mokomull/c64-cartridge/edge connector breakout/edge connector breakout.sch

## KiCad design edge connector breakout/edge connector breakout.sch (2020-06-07)

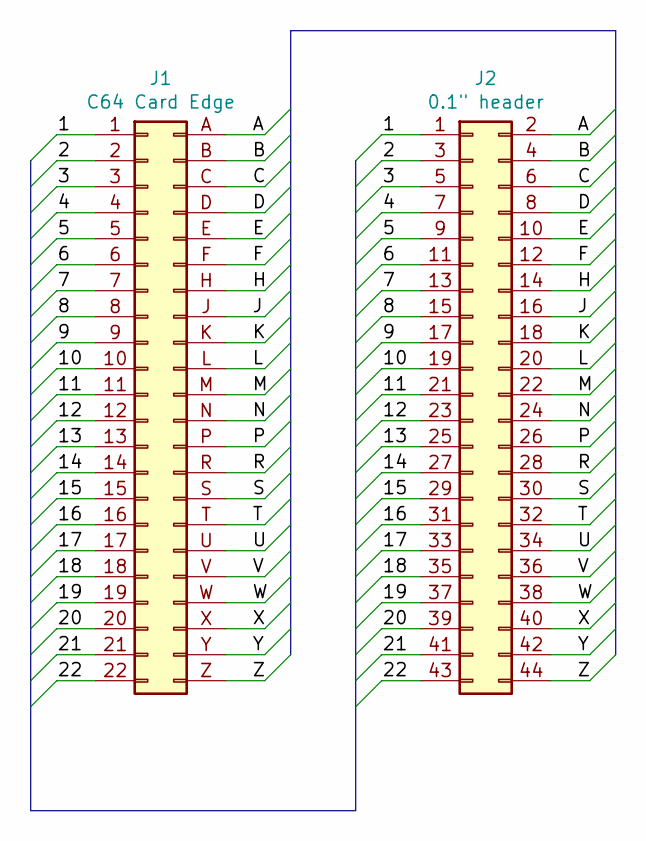
[picture p1: schematic edge connector breakout.sch]

Parts:
J1: C64 Card Edge; Expansion_Cartridge
J2: 0.1\" header; PinHeader_2x22_P2.54mm_Vertical

Connections:
1: J1.1, J2.1
2: J1.2, J2.3
3: J1.3, J2.5
4: J1.4, J2.7
5: J1.5, J2.9
6: J1.6, J2.11
7: J1.7, J2.13
8: J1.8, J2.15
9: J1.9, J2.17
10: J1.10, J2.19
11: J1.11, J2.21
12: J1.12, J2.23
13: J1.13, J2.25
14: J1.14, J2.27
15: J1.15, J2.29
16: J1.16, J2.31
17: J1.17, J2.33
18: J1.18, J2.35
19: J1.19, J2.37
20: J1.20, J2.39
21: J1.21, J2.41
22: J1.22, J2.43
A: J1.A, J2.2
B: J1.B, J2.4
C: J1.C, J2.6
D: J1.D, J2.8
E: J1.E, J2.10
F: J1.F, J2.12
H: J1.H, J2.14
J: J1.J, J2.16
K: J1.K, J2.18
L: J1.L, J2.20
M: J1.M, J2.22
N: J1.N, J2.24
P: J1.P, J2.26
R: J1.R, J2.28
S: J1.S, J2.30
T: J1.T, J2.32
U: J1.U, J2.34
V: J1.V, J2.36
W: J1.W, J2.38
X: J1.X, J2.40
Y: J1.Y, J2.42
Z: J1.Z, J2.44
