mokomull/c64-cartridge/usb/usb.sch

## KiCad design usb/usb.sch (2020-06-08)

Schematic: usb.sch

Parts:
J1: Expansion_Cartridge
U1: STM32F407VGTx; LQFP-100_14x14mm_P0.5mm
U2: 7130LA35PDG; TQFP-64_14x14mm_P0.8mm
U3: S29AL008J
