mokomull/c64-cartridge/(commit log)

2020-06-07 Initial stab at a breakout board
    [C64 Cartridge.kicad_pcb, C64 Cartridge.sch, edge connector breakout.kicad_pcb, edge connector breakout.sch]
2020-06-07 delete footprint cache
    This file seems to get completely replaced every time I load something
    new up in the footprint library.
2020-06-07 breakout pcb: add silkscreen labels for all pins
    [edge connector breakout.kicad_pcb]
2020-06-07 Remove the backup PCB file
    That's what git's for, no?
2020-06-07 Import CBM logo; place logo, serial, copyright
    [edge connector breakout.kicad_pcb]
2020-06-07 Mirror the edge connector in library, reset origin
    Origin of the footprint is now the center of pin 1. I don't know how
    this ever looked right on the PCB layout itself, the footprint hasn't
    been changed since "Initial commit". But somewhere along the line I
    definitely got the board-edge and the circuit side exactly backwards...
    [edge connector breakout.kicad_pcb]
2020-06-08 card edge: move the CrtYd border to 2.3" per spec
    [edge connector breakout.kicad_pcb]
2020-06-08 breakout: add CC0 to the copyright line
    [edge connector breakout.kicad_pcb]
2020-06-08 Move Commodore footprint library to root.
2020-06-08 usb: place some parts on a schematic
    I still need to finish wiring things together, but I'm definitely going
    to need a whole bunch of level shifters, some SRAM, and some flash that
    speaks the Commodore parallel bus. That's the part I'm most worried
    about: the ordering of addresses vs. clock signaling.
    Most of these parts are also not even the right schematic symbol (to be
    fixed later), but I've at least noted down part numbers that I'm going
    to need.
    Also to do later: add the combinatorial logic that's going to drive the
    set of CE# lines.
    [usb.kicad_pcb, usb.sch]
2020-06-14 Try to build a microcontroller-only variant.
    This is dependent on the µC being 5V-tolerant, and the Commodore side
    accepting 3.3V as a "1". I'm probably going to have to upgrade to a
    larger microcontroller package, since
    * a couple pins in port A are not 5V-tolerant, and
    * if the data bus is split into discontiguous portions of a bus, then
    the interrupt is going to need to do some mask+shift+or awfulness,
    which may not be fast enough.
    [usb, microcontroller only.kicad_pcb, usb, microcontroller only.sch]
2020-06-14 µC-only: move D4, D5 to PB0, PB1
    This will take at least a shift and a memory write (and a second memory
    write to the direction register) but this might work.
    Another option might be to shift them up to a high-bit in port A,
    avoiding the second set of direction registers if I can shoot the gap
    just right with alternate-functions
    [usb, microcontroller only.sch]
2020-06-14 µC-only: connect the internal power relugator cap
    [usb, microcontroller only.sch]
2020-07-07 µC-only: wire most of cartridge to µC
    This wires pretty much everything but the DMA lines to the
    microcontroller. That's still a bit too far for me :) Turns out I'm
    not going to need combinatoric logic because the PLA already
    decodes #IOx and #ROMx only when the CPU's AEC line is enable -- i.e.
    when it's the CPU's turn for the bus.
    I mostly grouped the outputs-toward-the-Commodore in the low bits of
    port B, and the inputs-from-the-Commodore in the high bits. Since this
    allows the microcontroller to control #GAME and #EXROM dynamically, as
    well as send interrupts and NMIs, I will hopefully be able to emulate as
    many existing peripherals as possible.
    The resistors on the data bus are cu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
    [usb, microcontroller only.sch]
2020-07-22 firmware: it's a start
    It's just a blinking LED. But it compiles.
2020-08-19 firmware: leave control lines floating for a "1"
    The C64 has built-in pull-ups for the cartridge control lines, so just
    leave them floating at the microcontroller side if we don't want to
    assert them. This prevents the microcontroller trying to output a
    "high" value and end up sinking current because it's being driven by the
    C64 to 5V.
    [main.rs]
2020-08-19 firmware: only output data lines for read requests
    The PLA doesn't decode ROML for writes when #GAME is deasserted anyway,
    but it doesn't hurt to be extra cautious.
    [main.rs]
2021-01-10 firmware: return data from a Frogger cartridge
    I was using the data from `Frogger_(Parker_Brothers).crt`, but that will
    need to be obtained separately.
    It seems that doing memory lookups in the critical section is just a bit
    too slow to reliably get data to the Commodore -- I observe at least one
    bit error about 10% of the time.
    Initially, I was just indexing into the FROGGER object. Thinking that
    the flash wait-states were causing my issues, I added the cache on the
    stack. As far as I can tell, rustc actually optimized that out, which
    is how the read_volatile() came to be.
    Unfortunately, none of those optimizations were enough to reliably read
    the CBM80 header.
    [main.rs]
2021-01-10 firmware: shave off one branch from the inner loop
    This is actually enough to reliably read bytes from the Frogger image!
    It takes long enough at boot that it doesn't immediately trip the
    Commodore's cartridge boot mechanism, but this is enough to launch into
    a green screen upon a SYS64738 command. It still does not seem to
    actually launch the game, though.
    [main.rs]
2021-01-11 firmware: run the 6502 assembler from build.rs
    This way I don't have to remember how to invoke `xa` every time. And I
    also can't forget *to* run it.
2021-02-28 Revert "firmware: shave off one branch from the inner loop"
    This reverts commit e886732039967a023046e17a1afe6b9c8236dd94.
    [main.rs]
2021-03-01 rom: the keyboard matrix is active LOW
    The 6526 has internal pull-ups for the input pins (columns, in the case
    of the keyboard), so any of the columns that had no keys depressed read
    back as a 1.
2021-03-08 firmware: trace address data and send to USB
    This ended up being too slow to reliably return data to the C64, but the
    tracing data dumping does work after poking the PD8 pin.
    From some PEEK(32768)s:
    0x8000 at 23671
    0x8000 at 23487
    0x8000 at 23364
    0x9f6e at 135605
    0x9f6f at 135441
    0x8002 at 130881
    0x9f6e at 7084977
    0x9f6f at 7084812
    0x8002 at 7080253
    0x9f6e at 5662144
    0x9f6f at 5661979
    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
    [main.rs]
