mokomull/c64-cartridge/(notices)

Notices in the files:
edge connector breakout/edge connector breakout.kicad_pcb:
© 2020 Matt Mullins
CC0 No Rights Reserved
